billylegota/6502sbc/(list of files, drawings)

Other design files:
hw/Old/Final 6502 SBC Fixed + LED AUTO.dip
hw/Old/Final 6502 SBC Fixed + LED.dch
hw/Old/Final 6502 SBC Fixed + LED.dip
hw/Old/Final 6502 SBC Fixed.dch
hw/Old/Final 6502 SBC.dch
hw/Old/New 6502 Computer.dch
hw/Old/Simplified 6502 SBC.dch
hw/Rev 0.1/6502 SBC Rev 0.1 (Changed SMD sizes) Attempt 1.dip
hw/Rev 0.1/6502 SBC Rev 0.1 (Changed SMD sizes) Attempt 2.dip
hw/Rev 0.1/6502 SBC Rev 0.1 (Changed SMD sizes) AUTO.dip
hw/Rev 0.1/6502 SBC Rev 0.1 (Changed SMD sizes).dch
hw/Rev 0.1/6502 SBC Rev 0.1 (Changed SMD sizes).dip
hw/Rev 0.2/6502 SBC Rev 0.1 (Changed SMD sizes).dch
hw/Rev 0.2/6502 SBC Rev 0.2 (Changed 6502 Orientation) Attempt 1.dip
hw/Rev 0.2/6502 SBC Rev 0.2 (Changed 6502 Orientation) Attempt 2.dip
hw/Rev 0.2/6502 SBC Rev 0.2 (Changed 6502 Orientation).dip
hw/Rev 0.3/6502 SBC Rev 0.1 (Changed SMD sizes).dch
hw/Rev 0.3/6502 SBC Rev 0.3 (Changed Trace Width) Attempt 1.dip
hw/Rev 0.4/6502 SBC Rev 0.1 (Changed SMD sizes).dch
hw/Rev 0.4/6502 SBC Rev 0.4 (Added Supports + Fixed Annular Ring) Attempt 1.dip
hw/Rev 0.4/6502 SBC Rev 0.4 (Added Supports + Fixed Annular Ring) Attempt 2.dip
hw/Rev 0.5/6502 SBC Rev 0.1 (Changed SMD sizes).dch
hw/Rev 0.5/6502 SBC Rev 0.5 (New Routing) Attempt 1 (Now with QR code!).dip
hw/Rev 0.5/6502 SBC Rev 0.5 (New Routing).dip
hw/Rev 0.5/6502 SBC Rev 0.5.1 (Flipped bypass caps).dip
hw/Rev 0.6/6502 SBC Rev 0.2.dch
hw/Rev 0.6/6502 SBC Rev 0.6.1.dip
hw/Rev 0.6/6502 SBC Rev 0.6.dip
