billylegota/6502sbc/(commit log)

2016-05-23 Updated Rev 0.5
    [6502 SBC Rev 0.5 (New Routing) Attempt 1 (Now with QR code!).dip, 6502 SBC Rev 0.5.1 (Flipped bypass caps).dip]
2018-07-26 Restructured files
    [6502 SBC Rev 0.1 (Changed SMD sizes) AUTO.dip, 6502 SBC Rev 0.1 (Changed SMD sizes) Attempt 1.dip, 6502 SBC Rev 0.1 (Changed SMD sizes) Attempt 2.dip, 6502 SBC Rev 0.1 (Changed SMD sizes) BOM.csv, 6502 SBC Rev 0.1 (Changed SMD sizes) BOM.xlsx, 6502 SBC Rev 0.1 (Changed SMD sizes).dch, 6502 SBC Rev 0.1 (Changed SMD sizes).dip, 6502 SBC Rev 0.2 (Changed 6502 Orientation) Attempt 1.dip]
2018-07-26 Added schematic PDF to docs
